lukecan/vizvizbot/docs/gorseller/braketler_v5_baski.png

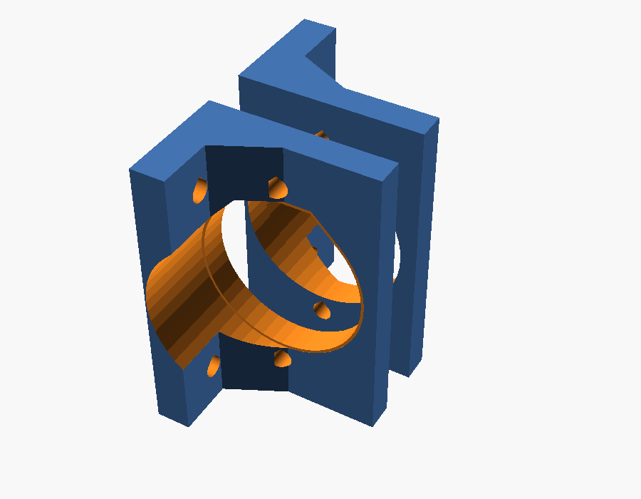
docs/gorseller/braketler_v5_baski.png
