lukecan/vizvizbot/docs/gorseller/teker_v3.png

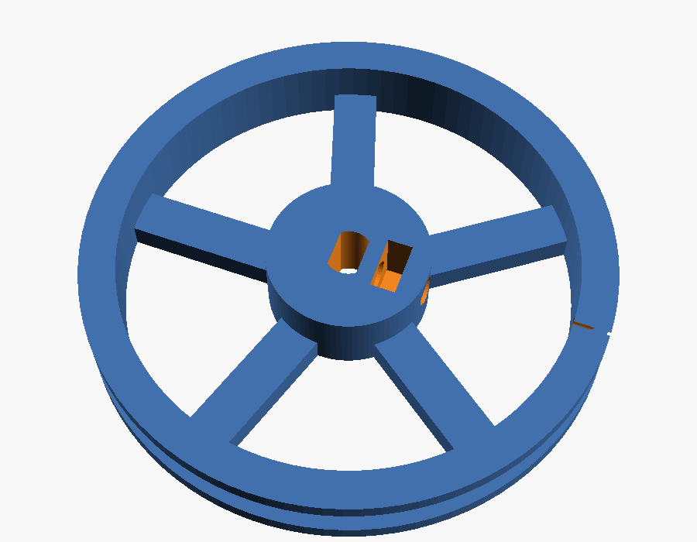
docs/gorseller/teker_v3.png
