lukecan/vizvizbot/stl/vizvizbot_braket_v11_yukseltici.stl

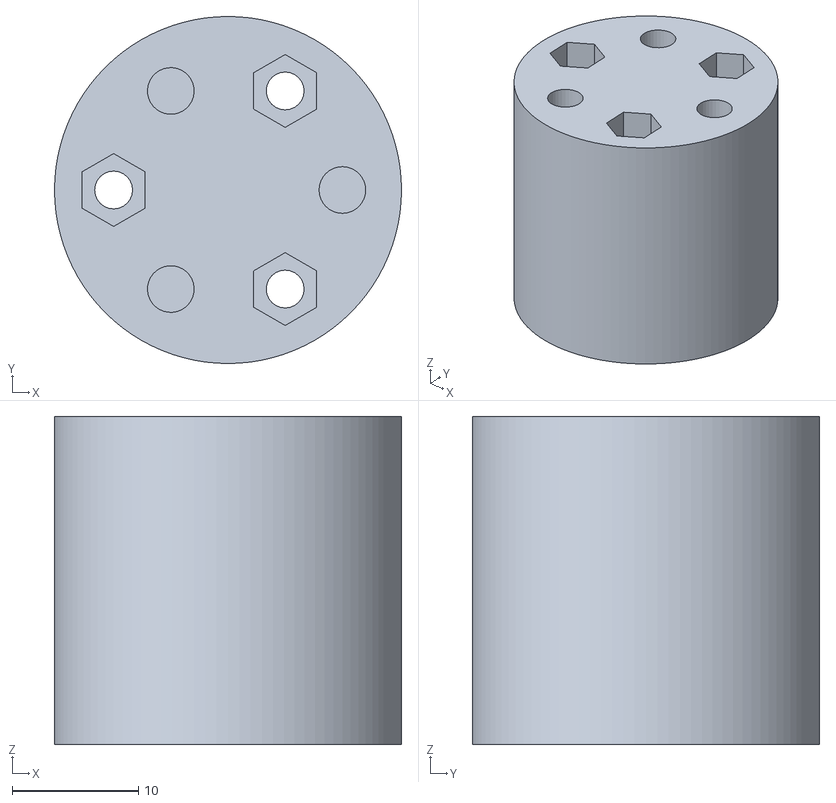
[picture p5: CAD file, 2026-10-30]
stl/vizvizbot_braket_v11_yukseltici.stl
27.5 x 27.5 x 26.0
