lukecan/vizvizbot/stl/vizvizbot_braket_v11_braketler.stl

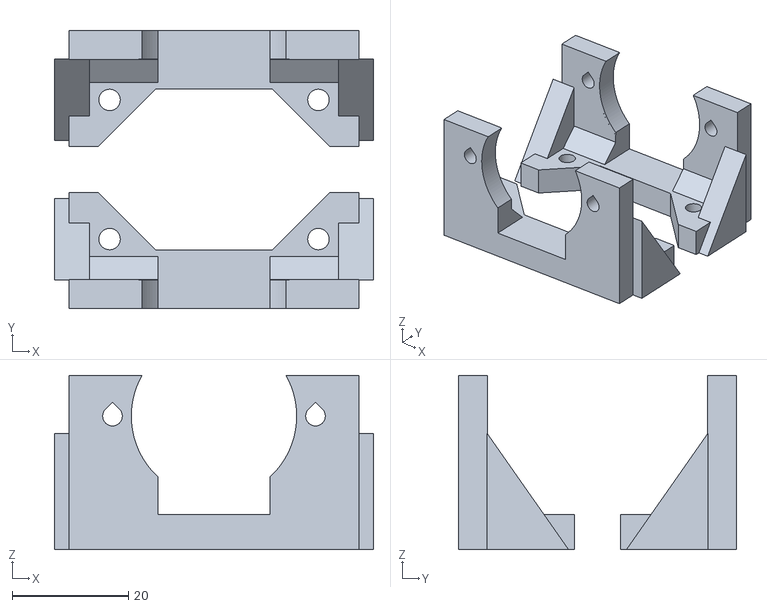
[picture p6: CAD file, 2026-10-29]
stl/vizvizbot_braket_v11_braketler.stl
55.0 x 48.0 x 30.0
