lukecan/vizvizbot/stl/vizvizbot_sasi_v5_braketler.stl

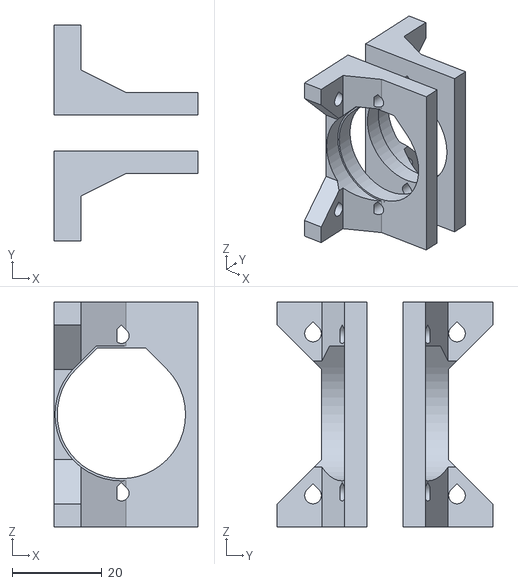
[picture p7: CAD file, 2026-10-25]
stl/vizvizbot_sasi_v5_braketler.stl
32.0 x 48.0 x 50.0
