lukecan/vizvizbot/stl/vizvizbot_sasi_v5_plaka.stl

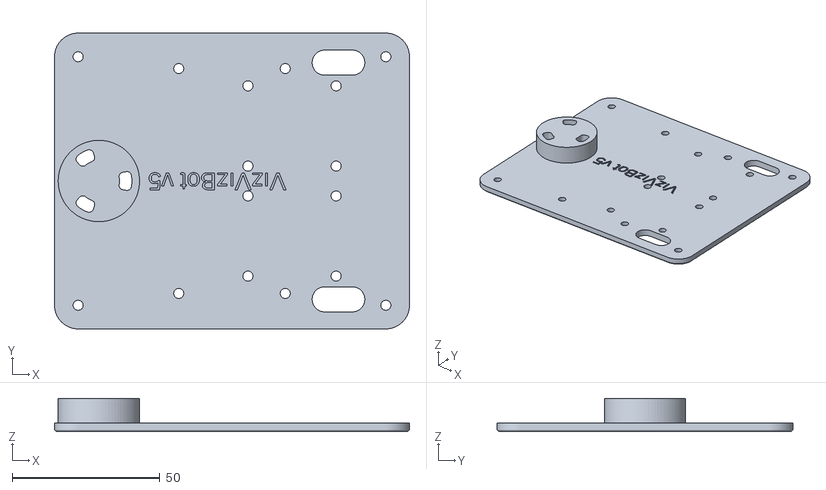
[picture p8: CAD file, 2026-10-25]
stl/vizvizbot_sasi_v5_plaka.stl
120.0 x 100.0 x 11.2
