lukecan/vizvizbot/stl/vizvizbot_teker_v3.stl

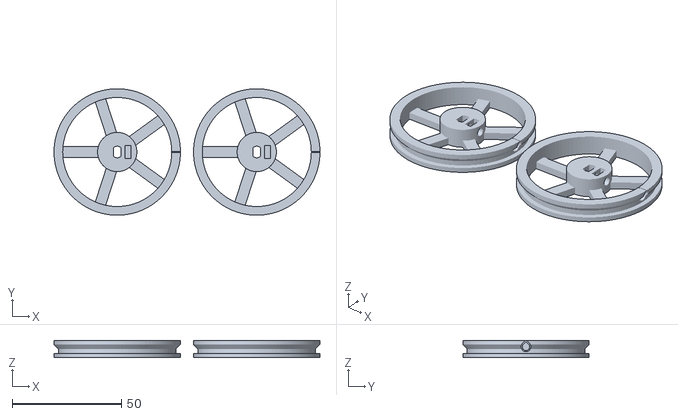
[picture p9: CAD file, 2026-10-25]
stl/vizvizbot_teker_v3.stl
122.0 x 58.0 x 8.00
