lukecan/vizvizbot/stl/vizvizbot_kabuk_v1_kabuk.stl

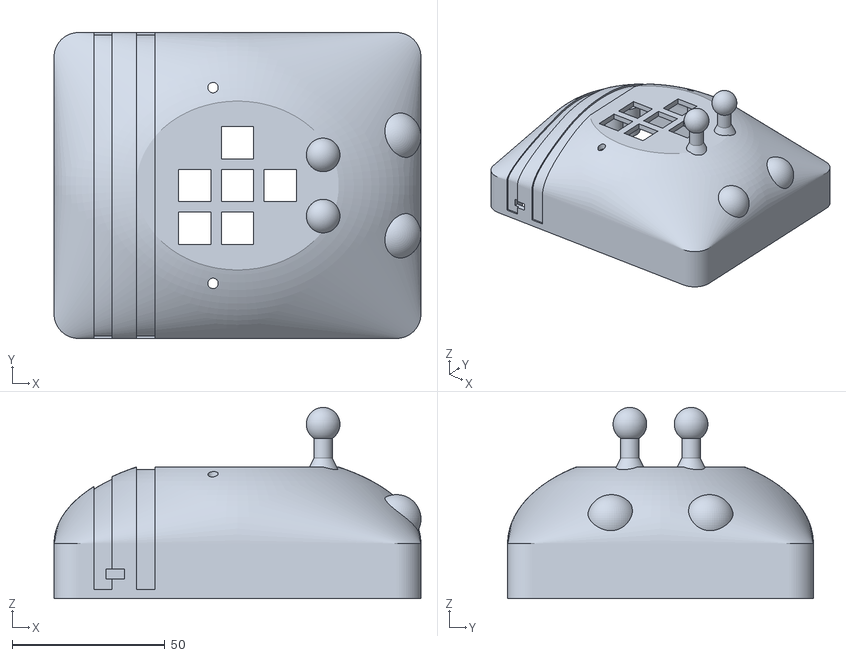
[picture p10: CAD file, 2026-10-25]
stl/vizvizbot_kabuk_v1_kabuk.stl
120.0 x 100.0 x 62.5
