lukecan/vizvizbot/stl/vizvizbot_kabuk_v1_kanatlar.stl

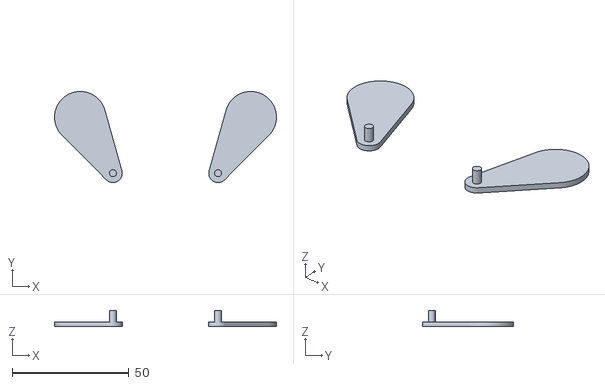
[picture p11: CAD file, 2026-10-25]
stl/vizvizbot_kabuk_v1_kanatlar.stl
95.0 x 39.0 x 7.00
