lukecan/vizvizbot/stl/vizvizbot_kabuk_v1_kapaklar.stl

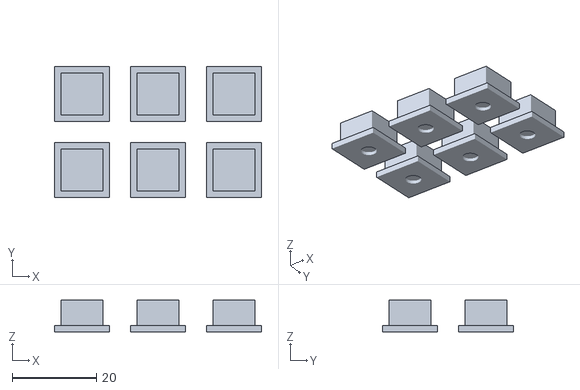
[picture p12: CAD file, 2026-10-25]
stl/vizvizbot_kabuk_v1_kapaklar.stl
49.0 x 31.0 x 7.50
