lukecan/vizvizbot/(list of files, cad)

Other CAD files:
cad/arsiv/ari_bot_sasi_v3.scad
cad/arsiv/vizvizbot_braket_v10.scad
cad/arsiv/vizvizbot_sasi_v8.scad
cad/arsiv/vizvizbot_teker_v2.scad
cad/arsiv/ari_bot_sasi_v1.scad
cad/arsiv/ari_bot_sasi_v2.scad
cad/arsiv/vizvizbot_braket_v9.scad
cad/arsiv/vizvizbot_sasi_v4.scad
cad/arsiv/vizvizbot_sasi_v5.scad
cad/arsiv/vizvizbot_sasi_v6.scad
cad/arsiv/vizvizbot_sasi_v7.scad
