lukecan/vizvizbot/docs/gorseller/kabuk_v1_montaj.png

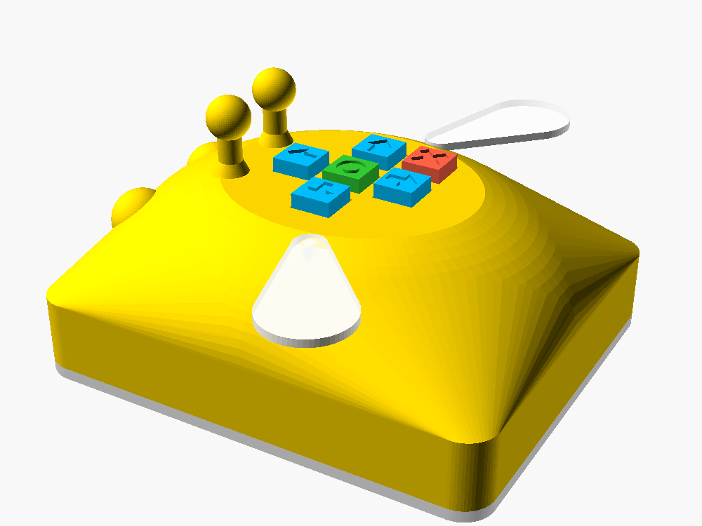
docs/gorseller/kabuk_v1_montaj.png
