lukecan/vizvizbot/(commit log)

2026-10-25 VızVızBot: şasi v5, teker v3, kabuk v1, firmware ve geliştirme günlüğü
    Claude-Session: https://claude.ai/code/session_01VrZC1Pm7P3SJYLvNU4X9MF
    [ari_bot_sasi_v1.scad, ari_bot_sasi_v2.scad, ari_bot_sasi_v3.scad, tolerans_testi.scad, vizvizbot_kabuk_v1.scad, vizvizbot_kabuk_v1_kabuk.stl, vizvizbot_kabuk_v1_kanatlar.stl, vizvizbot_kabuk_v1_kapaklar.stl]
2026-10-25 Şasi v5: braket flanşının ortası ULN2003 vida başları için açıldı
    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
    [vizvizbot_sasi_v5.scad, vizvizbot_sasi_v5_braketler.stl, vizvizbot_sasi_v5_plaka.stl]
2026-10-26 Braket v7: v4'ün U şekli ve ölçüleri korunarak güçlendirildi; tek tabla baskı sonucu ve Gyroid ayarı
    - v5 braketteki destek üçgeni motor kulak somunlarına çarpıyordu
    - v6 (somun cebi) arşive alındı, kullanılmadı
    - v7: yan yatık baskı, 4 mm duvar, flanş + insert, 5 mm iç pah
    - README ve günlük güncellendi
    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
    [vizvizbot_sasi_v5.scad, vizvizbot_sasi_v6.scad, vizvizbot_sasi_v7.scad, vizvizbot_sasi_v7_braketler.stl]
2026-10-29 Braket v11 (son hali): motor ters, mavi kapak yukarıda; v8-v10 arşivde; günlüğe braket maratonu
    - v11: ayrı parça, tam yuvarlak delik + mavi kapak yuvası, kapağın üstünde 6 mm bant,
    alt açık U, 5 mm duvar, büyük uç üçgenleri; yerden yükseklik 4 mm -> 24 mm
    - Sarhoş teker için 24 mm yükseltici (M2x40 cıvata)
    - README: durum, malzeme listesi, baskı ayarları, montaj adımları güncellendi
    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
    [vizvizbot_braket_v10.scad, vizvizbot_braket_v11.scad, vizvizbot_braket_v11_braketler.stl, vizvizbot_braket_v11_yukseltici.stl, vizvizbot_braket_v9.scad, vizvizbot_sasi_v7.scad, vizvizbot_sasi_v7_braketler.stl, vizvizbot_sasi_v8.scad]
2026-10-30 Firmware: ters motor montajı için yön düzeltmesi (SOL_YON=-1, SAG_YON=1)
    - ilk_surus_testi: yön sabitleri ters çevrildi (test: tekerler geri dönüyordu)
    - beebot_sim: hareketler artık SOL_YON / SAG_YON sabitlerini kullanıyor
    - Braket v11 yükseltici: somun yuvaları üstte, cıvata başları tekerde, 26 mm
    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
    [beebot_sim.ino, ilk_surus_testi.ino]
2026-10-30 Braket v11: güncel yükseltici (26 mm, üstte somun yuvaları)
    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
    [vizvizbot_braket_v11.scad, vizvizbot_braket_v11_yukseltici.stl]
